AerodyneLabs/Atlas/README.md

Atlas
=====

mbed Nucleo based high-altitude balloon data logger
