AerodyneLabs/Atlas/Hardware/Atlas.kicad_pcb

## KiCad design Hardware/Atlas.kicad_pcb (2014-10-30)

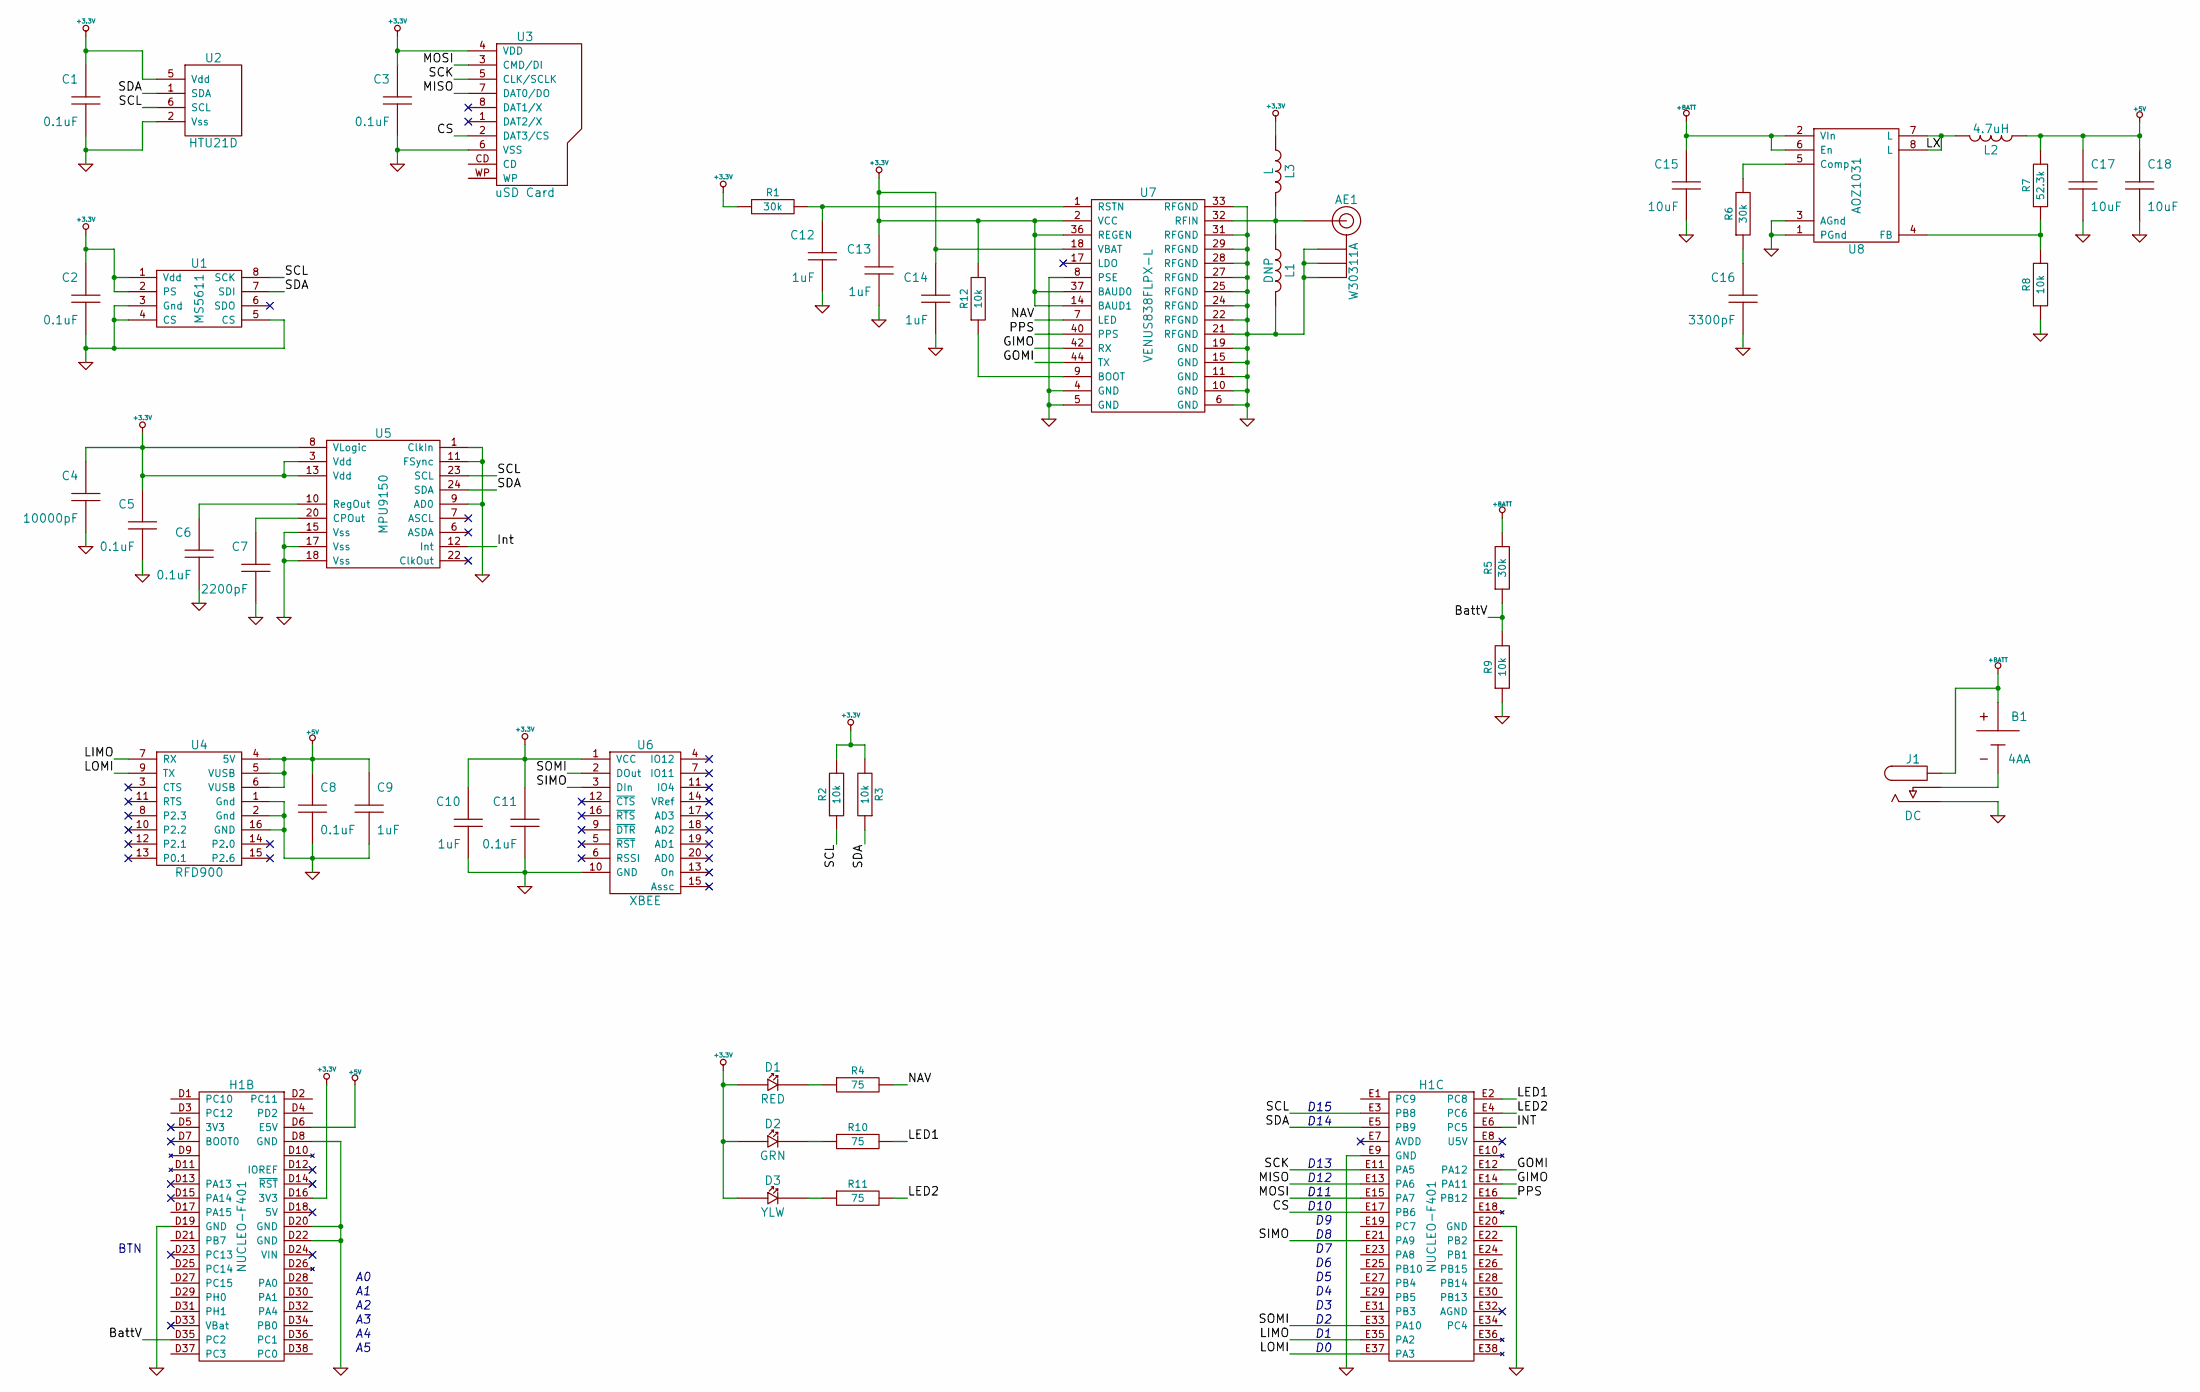
[picture p2: schematic Atlas.sch, Atlas (Nucleo Shield)]

Parts:
AE1: W30311A; MFR Part No W3011A
B1: 4AA; MFR Part No 2477
C1, C2, C3, C5, C6, C8, C11: 0.1uF; CAPC1608-N; Voltage 16V; MFR Part No CL10B104KO8NNNC
C4: 10000pF; CAPC1608-N; Voltage 50V; MFR Part No CL10B103KB8NNNC
C7: 2200pF; CAPC1608-N; Voltage 50V; MFR Part No CL10B222KB8SFNC
C9, C10, C12, C13, C14: 1uF; CAPC1608-N; Voltage 10V; MFR Part No CL10B105KP8NNNC
C15, C17, C18: 10uF; CAPC2012-N; Voltage 16V; MFR Part No CL21A106KOFNNNE
C16: 3300pF; CAPC1608-N; Voltage 50V; MFR Part No CL10B332KB8SFNC
D1: RED; LEDC1608-N; Voltage 1.9V; MFR Part No LS Q971-KN-1
D2: GRN; LEDC1608-N; Voltage 2.2V; MFR Part No LG Q971-KN-1
D3: YLW; LEDC1608-N; Voltage 2.0V; MFR Part No LY Q976-P1S2-36
H1: NUCLEO-F401
J1: DC; MFR Part No PJ-202A
L1: DNP; INDC1005-N
L2: 4.7uH; INDC-SRN4018; MFR Part No SRN4018-4R7M
L3: L
R1, R5, R6: 30k; RESC1608-N; Tolerance 5%; MFR Part No MCR03ERTJ303
R2, R3, R8, R9, R12: 10k; RESC1608-N; Tolerance 5%; MFR Part No MCR03ERTJ103
R4, R10, R11: 75; RESC1608-N; Tolerance 5%; MFR Part No MCR03ERTJ750
R7: 52.3k; RESC1608-N; Tolerance 1%; MFR Part No MCR03ERTF5232
U1: MS5611
U2: HTU21D
U3: uSD Card; MFR Part No 101-00303-68
U4: RFD900; MFR Part No PPPC082LJBN-RC
U5: MPU9150
U6: XBEE; MFR Part No NPPN101BFCN-RC
U7: VENUS838FLPX-L
U8: AOZ1031; MFR Part No AOZ1031AI

Connections:
+3.3V: C1.1, C2.1, C3.1, C4.1, C5.1, C10.1, C11.1, C13.1, C14.1, D1.1, D2.1, D3.1, H1.D16 (3V3), L3.2, R1.1, R2.2, R3.2, R12.2, U1.1 (Vdd), U1.2 (PS), U2.5 (Vdd), U3.4 (VDD), U5.3 (Vdd), U5.8 (VLogic), U5.13 (Vdd), U6.1 (VCC), U7.2 (VCC), U7.14 (BAUD1), U7.18 (VBAT), U7.36 (REGEN), U7.37 (BAUD0)
+5V: C8.1, C9.1, C17.1, C18.1, H1.D6 (E5V), L2.2, R7.2, U4.4 (5V), U4.5 (VUSB), U4.6 (VUSB)
+BATT: B1.1, C15.1, J1.1, R5.2, U8.2 (VIn), U8.6 (En)
/BattV: H1.D35 (PC2), R5.1, R9.2
/CS: H1.E17 (PB6), U3.2 (DAT3/CS)
/GIMO: H1.E14 (PA11), U7.42 (RX)
/GOMI: H1.E12 (PA12), U7.44 (TX)
/INT: H1.E6 (PC5), U5.12 (Int)
/LED1: H1.E2 (PC8), R10.2
/LED2: H1.E4 (PC6), R11.2
/LIMO: H1.E35 (PA2), U4.7 (RX)
/LOMI: H1.E37 (PA3), U4.9 (TX)
/LX: L2.1, U8.7 (L), U8.8 (L)
/MISO: H1.E13 (PA6), U3.7 (DAT0/DO)
/MOSI: H1.E15 (PA7), U3.3 (CMD/DI)
/NAV: R4.2, U7.7 (LED)
/PPS: H1.E16 (PB12), U7.40 (PPS)
/SCK: H1.E11 (PA5), U3.5 (CLK/SCLK)
/SCL: H1.E3 (PB8), R2.1, U1.8 (SCK), U2.6 (SCL), U5.23 (SCL)
/SDA: H1.E5 (PB9), R3.1, U1.7 (SDI), U2.1 (SDA), U5.24 (SDA)
/SIMO: H1.E21 (PA9), U6.3 (DIn)
/SOMI: H1.E33 (PA10), U6.2 (DOut)
GND: AE1.S, C1.2, C2.2, C3.2, C4.2, C5.2, C6.2, C7.2, C8.2, C9.2, C10.2, C11.2, C12.2, C13.2, C14.2, C15.2, C16.2, C17.2, C18.2, H1.D8 (GND), H1.D19 (GND), H1.D20 (GND), H1.D22 (GND), H1.E9 (GND), H1.E20 (GND), J1.2, L1.1, R8.1, R9.1, U1.3 (Gnd), U1.4 (CS), U1.5 (CS), U2.2 (Vss), U3.6 (VSS), U4.1 (Gnd), U4.2 (Gnd), U4.16 (GND), U5.1 (ClkIn), U5.9 (AD0), U5.11 (FSync), U5.15 (Vss), U5.17 (Vss), U5.18 (Vss), U6.10 (GND), U7.4 (GND), U7.5 (GND), U7.6 (GND), U7.8 (PSE), U7.10 (GND), U7.11 (GND), U7.15 (GND), U7.19 (GND), U7.21 (RFGND), U7.22 (RFGND), U7.24 (RFGND), U7.25 (RFGND), U7.27 (RFGND), U7.28 (RFGND), U7.29 (RFGND), U7.31 (RFGND), U7.33 (RFGND), U8.1 (PGnd), U8.3 (AGnd)
unnamed: C6.1, U5.10 (RegOut)
unnamed: C7.1, U5.20 (CPOut)
unnamed: C12.1, R1.2, U7.1 (RSTN)
unnamed: R12.1, U7.9 (BOOT)
unnamed: C16.1, R6.1
unnamed: R6.2, U8.5 (Comp)
unnamed: D2.2, R10.1
unnamed: D3.2, R11.1
unnamed: R7.1, R8.2, U8.4 (FB)
unnamed: B1.2, J1.3
unnamed: D1.2, R4.1
unnamed: AE1.P, L1.2, L3.1, U7.32 (RFIN)

Notes on the sheet:
D10
D11
D12
D13
D14
D15
BTN

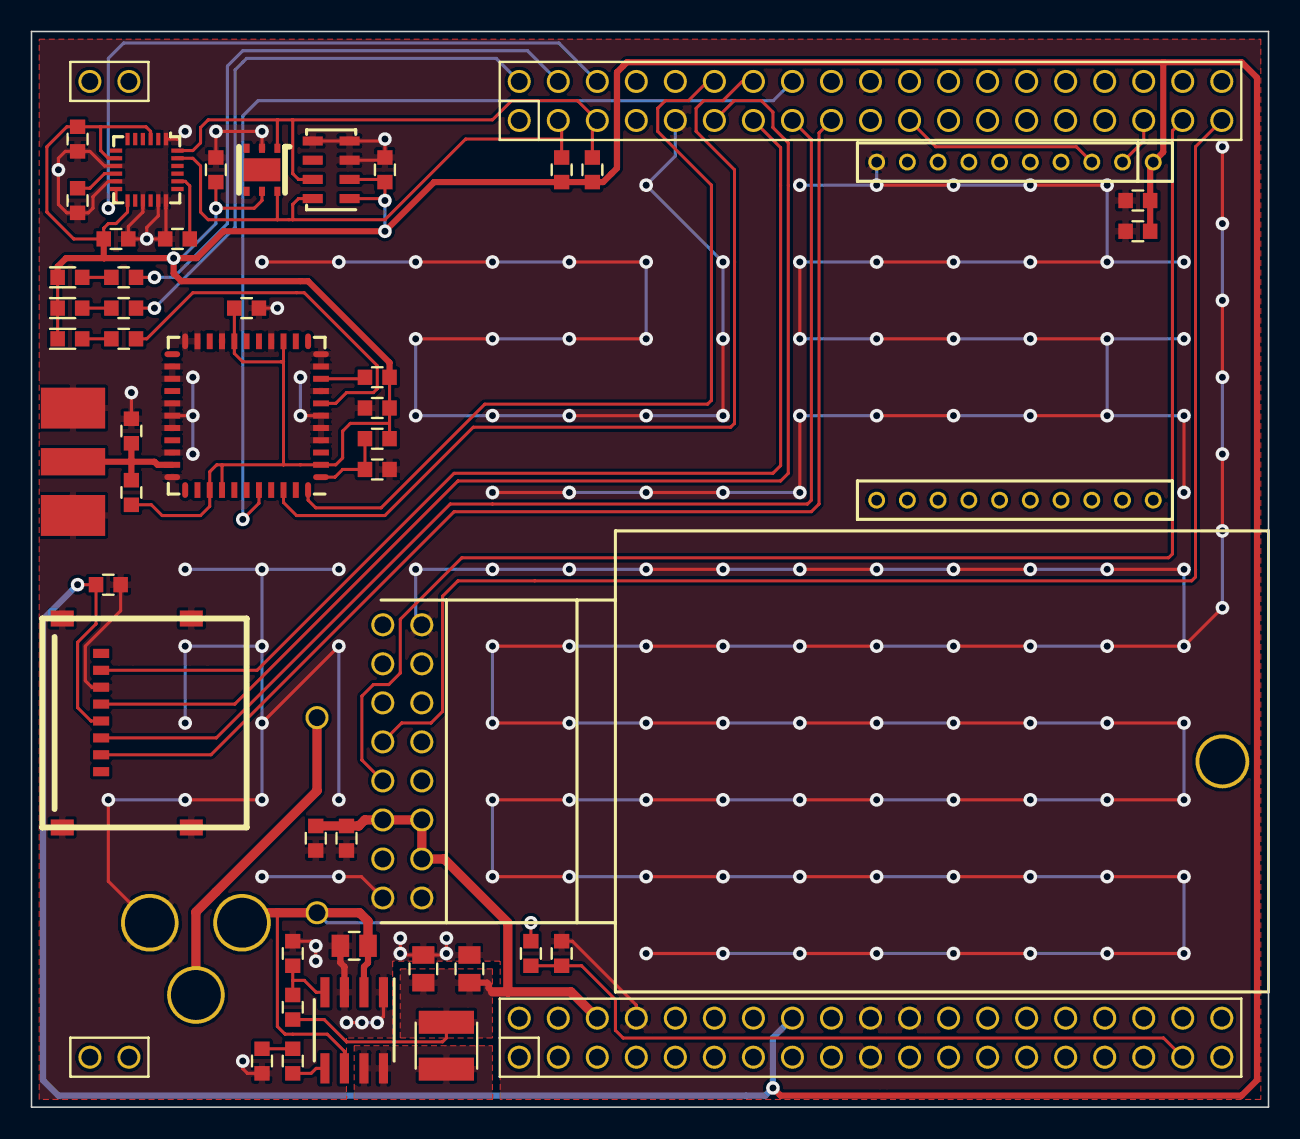
[picture p3: board Atlas.kicad_pcb from above]

Board: 2 copper layers, 80.5 x 70.0 mm, 48 parts (1 on the bottom side), 35 nets.
