AerodyneLabs/Atlas/(commit log)

2014-05-20 KiCad project configuration
2014-05-21 Add major components to schematic
    [Atlas.sch]
2014-05-22 Change to bottom shield, remove arduino pins
    [Atlas.sch]
2014-05-22 Add sensor datasheets
2014-05-22 Add sensor support components
    [Atlas.sch]
2014-05-22 Wire SD Card
    [Atlas.sch]
2014-05-23 Layout schematic to reflect board
    [Atlas.sch]
2014-05-23 Remove XTend because it is stupid
    [Atlas.sch]
2014-05-23 Add GPS to schematic
    [Atlas.sch]
2014-05-23 Radio support components
    [Atlas.sch]
2014-05-24 Rough netlist, association and layout
    [Atlas.kicad_pcb, Atlas.sch]
2014-05-24 Add 5v regulator and remove before flight switch
    [Atlas.kicad_pcb, Atlas.sch]
2014-05-24 Connect serial peripherals
    [Atlas.sch]
2014-05-24 Remove split GPS ground
    [Atlas.sch]
2014-05-25 Majority of layout and routing
    [Atlas.kicad_pcb, Atlas.sch]
2014-05-25 Pre-review layout
    [Atlas.kicad_pcb]
2014-05-26 Add LEDs
    [Atlas.kicad_pcb, Atlas.sch]
2014-05-26 Finish PCB
    [Atlas.kicad_pcb, Atlas.sch]
2014-05-28 Update gitignore for gerber outputs
2014-05-28 Add branding to pcb
    [Atlas.kicad_pcb]
2014-05-28 DFM changes
    [Atlas.kicad_pcb]
2014-06-01 Update GPS to support Flash and ROM versions
    [Atlas.kicad_pcb, Atlas.sch]
2014-06-01 Add isolation routing and ground stitching
    [Atlas.kicad_pcb]
2014-06-03 Finish component values and BOM fields
    [Atlas.sch]
2014-10-18 Switch IMU to QFN footprint
    Fixes #6
    [Atlas.kicad_pcb]
2014-10-18 Connect GPS PPS output
    Closes #5
    [Atlas.kicad_pcb, Atlas.sch]
2014-10-30 Switch GPS to SMA antennas port
    Add pull up inductor to support active antenna. Closes #7
    [Atlas.kicad_pcb, Atlas.sch]
